srunr/NIBE360_zwave_remote_control/NIBE 360 REMOTE ZWAVE CONTROL PARTS LIST.docx

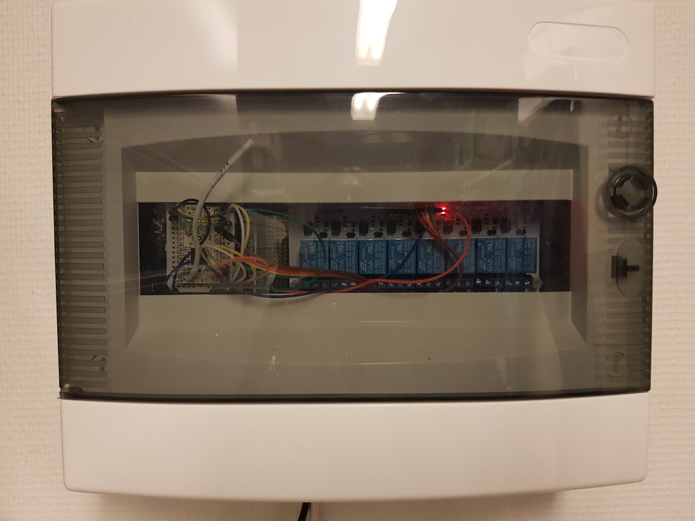
[picture p2: figure]
